SebyR/SmartMed-Dispenser/Poze proiect/20201019_083624.jpg

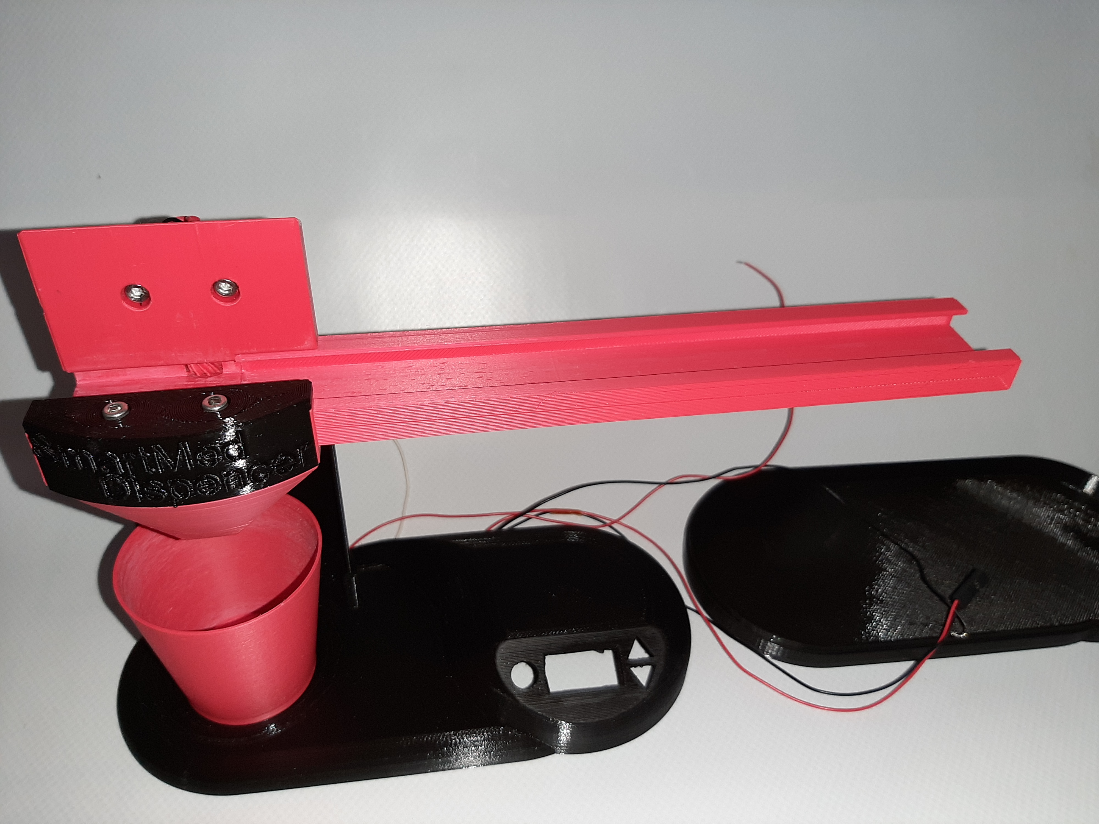
Poze proiect/20201019_083624.jpg
