SebyR/SmartMed-Dispenser/Poze proiect/20201019_083353.jpg

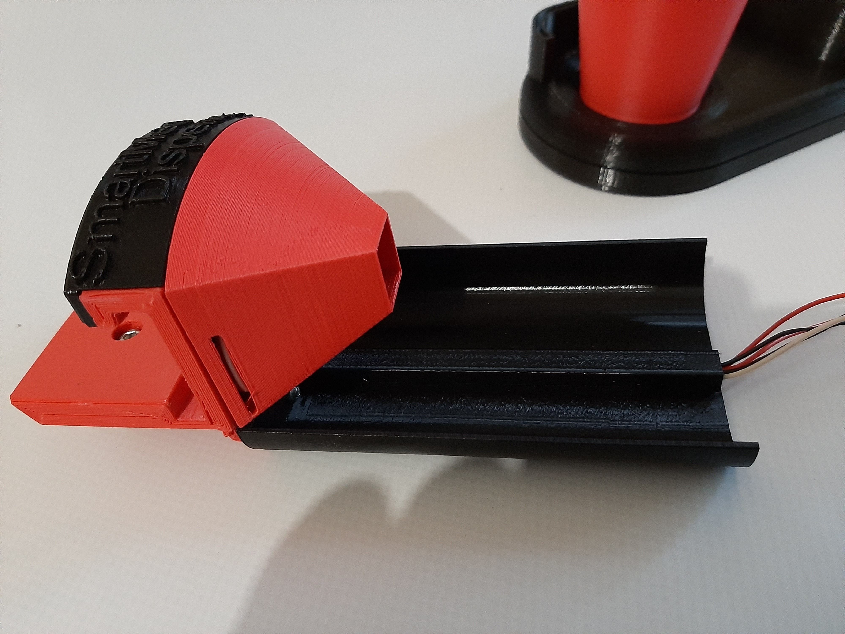
Poze proiect/20201019_083353.jpg
