SebyR/SmartMed-Dispenser/README.md

# SmartMed-Dispenser
Dispozitiv inteligent programabil pentru organizarea și dozarea medicației zilnice a persoanelor în vârstă
