SebyR/SmartMed-Dispenser/Poze proiect/20201018_154645.jpg

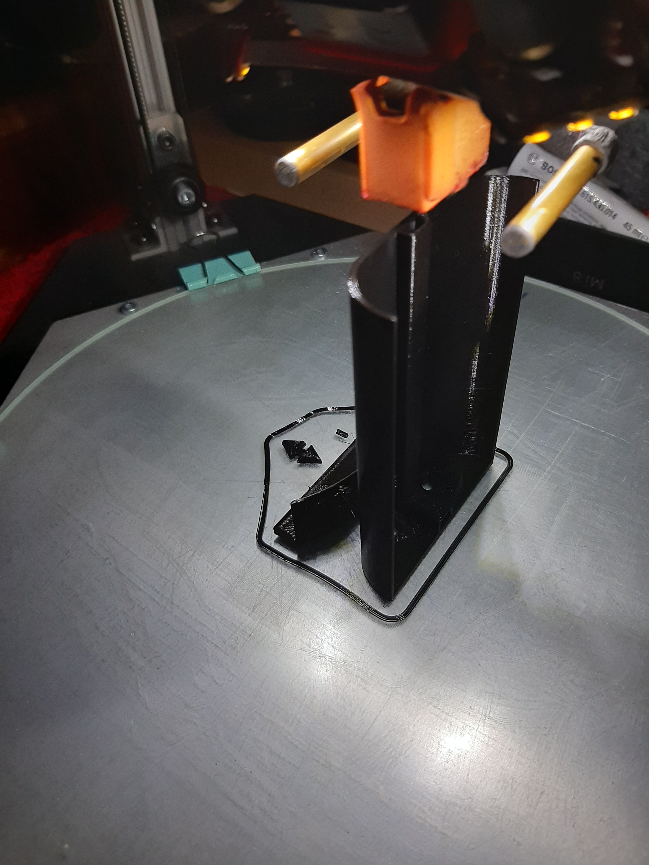
Poze proiect/20201018_154645.jpg
