SebyR/SmartMed-Dispenser/Poze proiect/20201019_083313.jpg

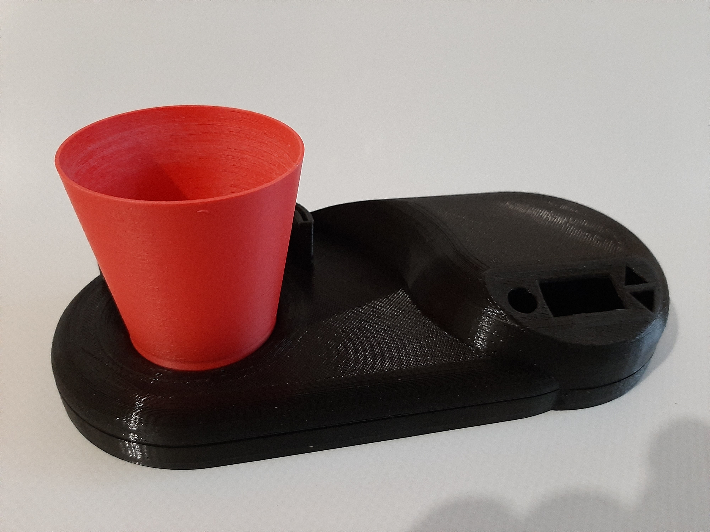
Poze proiect/20201019_083313.jpg
