SebyR/SmartMed-Dispenser/Poze proiect/20201019_083321.jpg

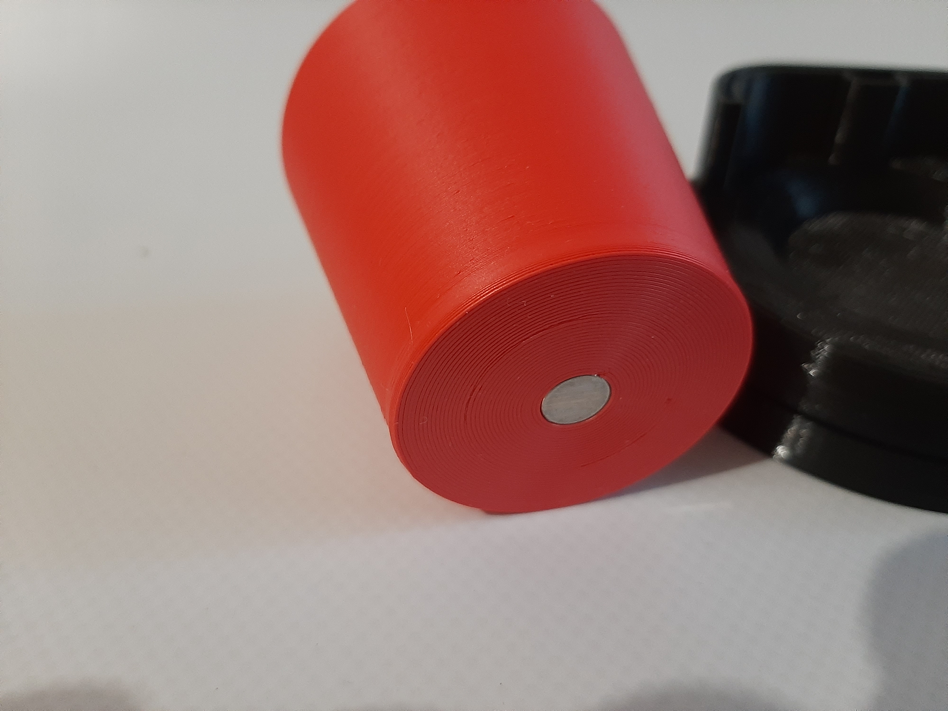
Poze proiect/20201019_083321.jpg
