SebyR/SmartMed-Dispenser/Poze proiect/20201019_083421.jpg

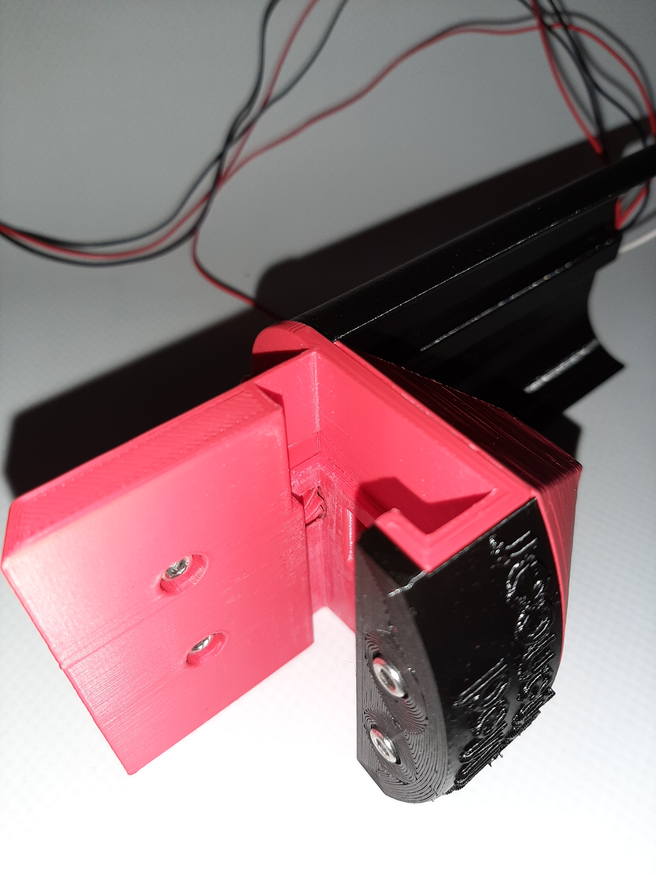
Poze proiect/20201019_083421.jpg
