SebyR/SmartMed-Dispenser/Poze proiect/20201019_083508.jpg

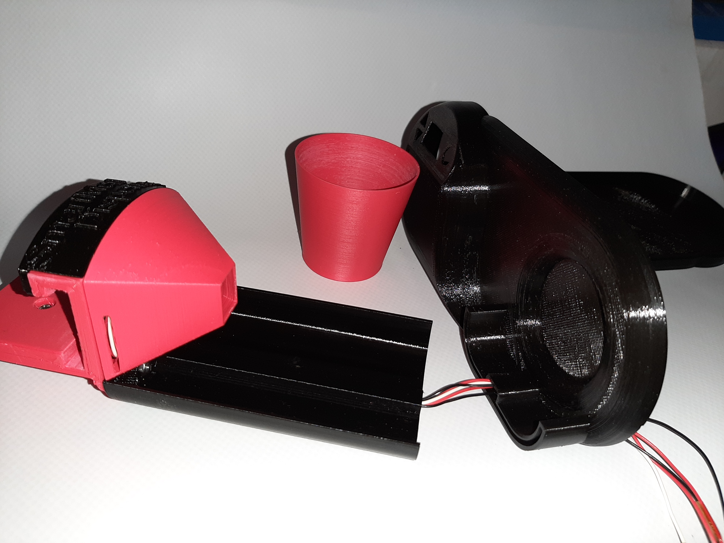
Poze proiect/20201019_083508.jpg
