SebyR/SmartMed-Dispenser/Poze proiect/20201019_083731.jpg

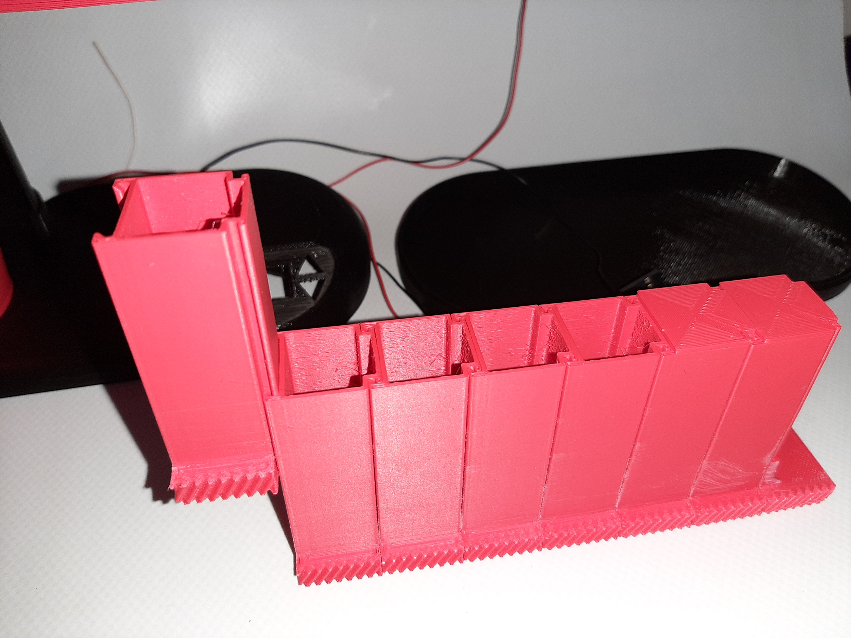
Poze proiect/20201019_083731.jpg
