SebyR/SmartMed-Dispenser/Poze proiect/20201019_083916.jpg

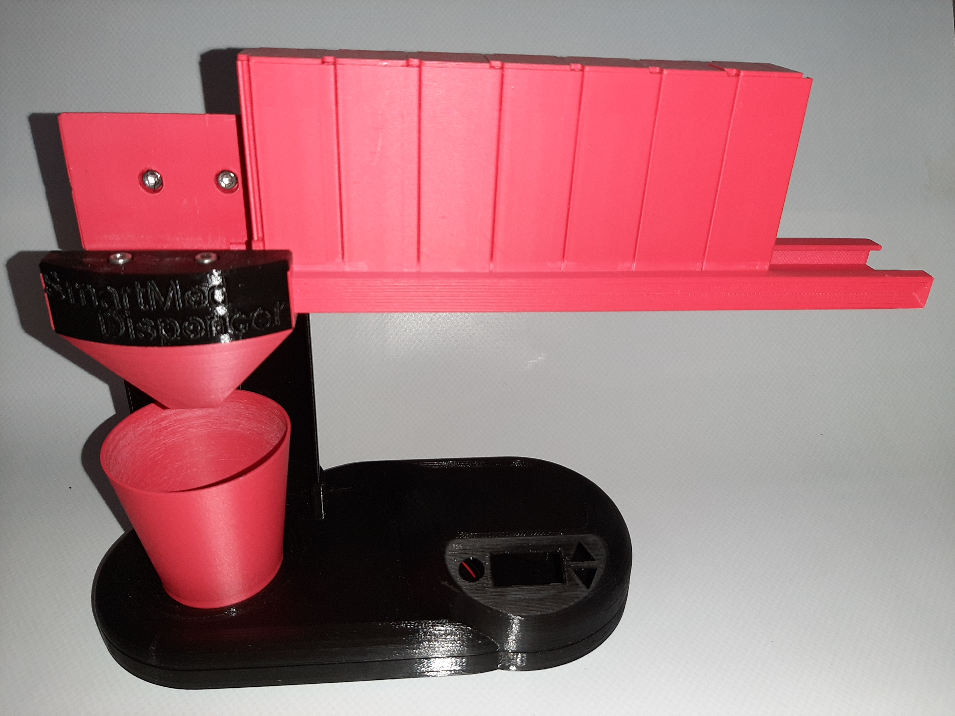
Poze proiect/20201019_083916.jpg
