SebyR/SmartMed-Dispenser/Poze proiect/20210425_174214.jpg

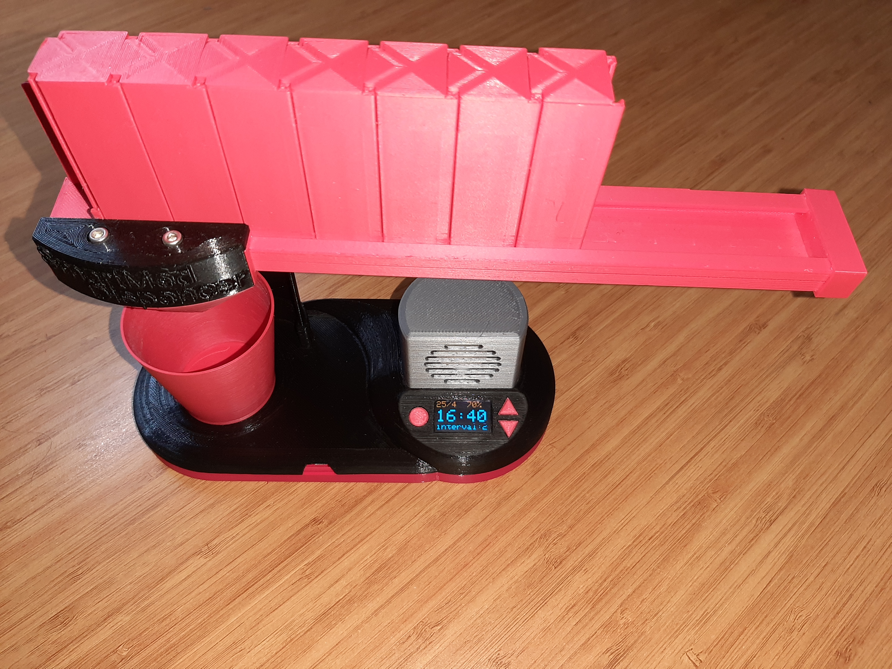
Poze proiect/20210425_174214.jpg
