SebyR/SmartMed-Dispenser/Stl-uri/Sina_dr1.stl

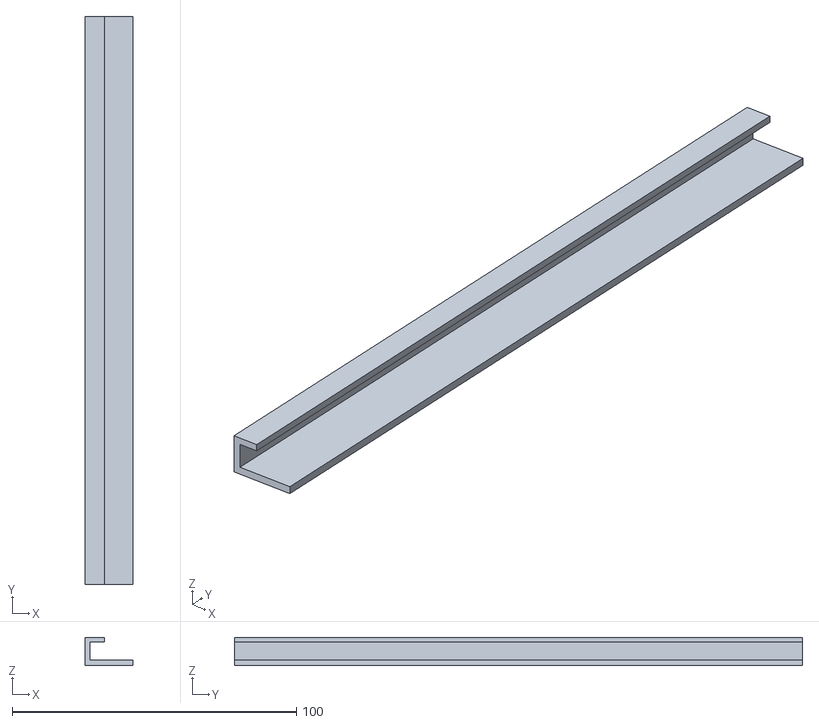
[picture p23: CAD file, 2021-04-27]
Stl-uri/Sina_dr1.stl
17.0 x 200.0 x 10.0
