SebyR/SmartMed-Dispenser/Stl-uri/Pahar.stl

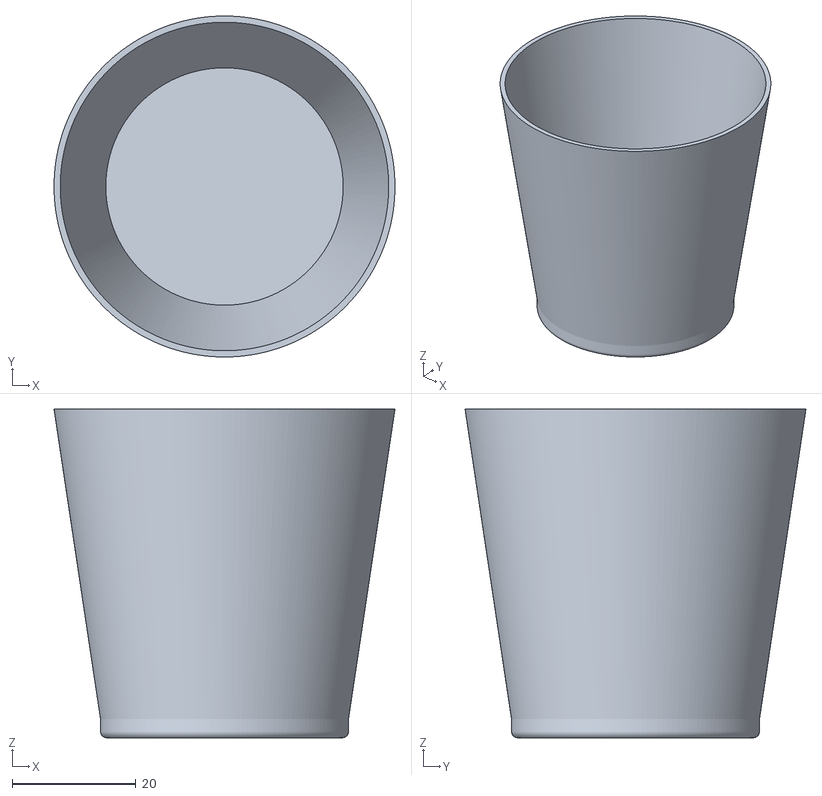
[picture p24: CAD file, 2021-04-27]
Stl-uri/Pahar.stl
55.0 x 55.0 x 53.0
