SebyR/SmartMed-Dispenser/Stl-uri/Capac_frontal.stl

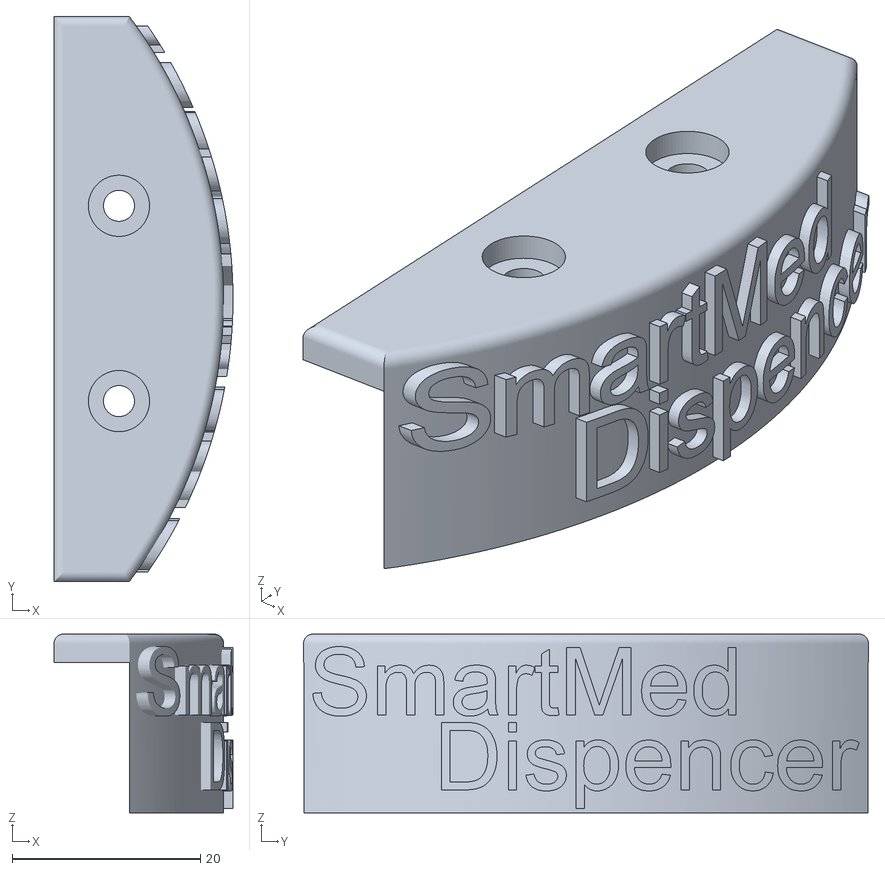
[picture p25: CAD file, 2021-04-27]
Stl-uri/Capac_frontal.stl
19.0 x 60.0 x 19.0
