SebyR/SmartMed-Dispenser/Stl-uri/Capac_sina.stl

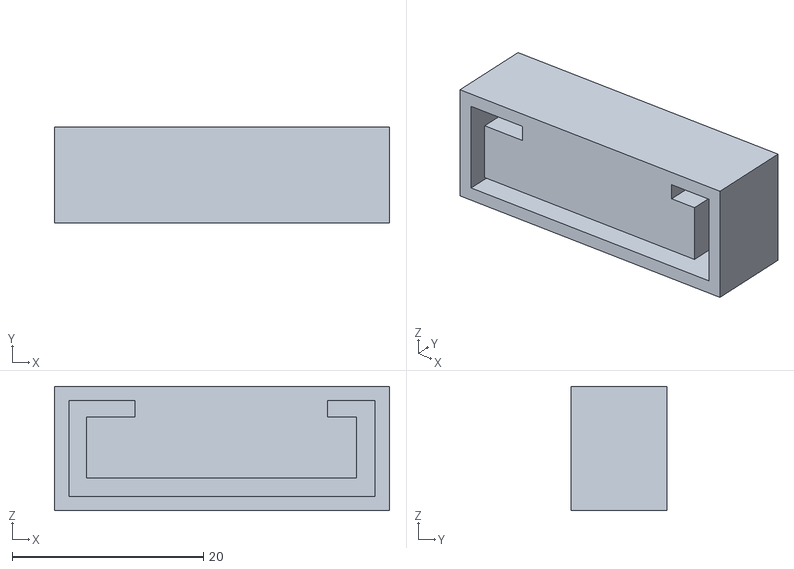
[picture p26: CAD file, 2021-04-27]
Stl-uri/Capac_sina.stl
35.0 x 10.0 x 13.0
