SebyR/SmartMed-Dispenser/Stl-uri/Buton+-.stl

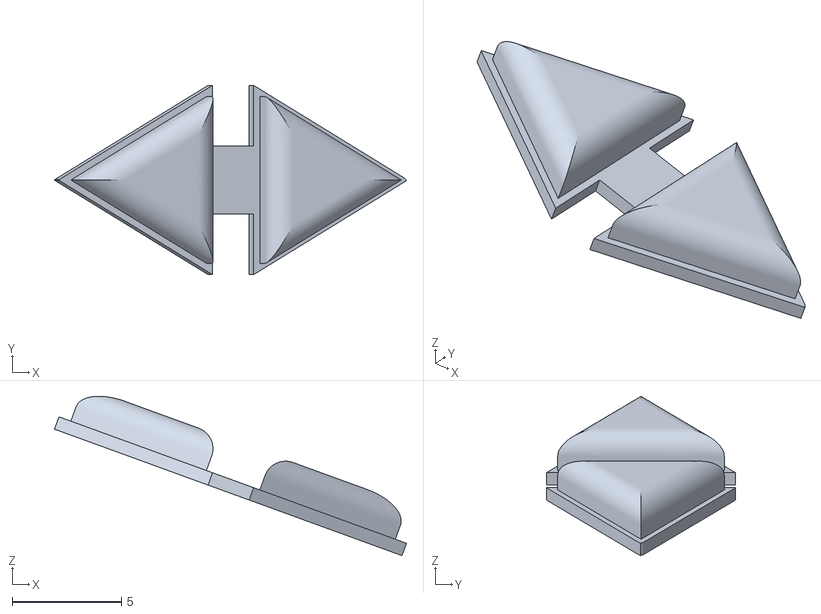
[picture p27: CAD file, 2021-04-27]
Stl-uri/Buton+-.stl
16.1 x 8.66 x 7.29
