SebyR/SmartMed-Dispenser/Stl-uri/Stativ_jos_rosu.stl

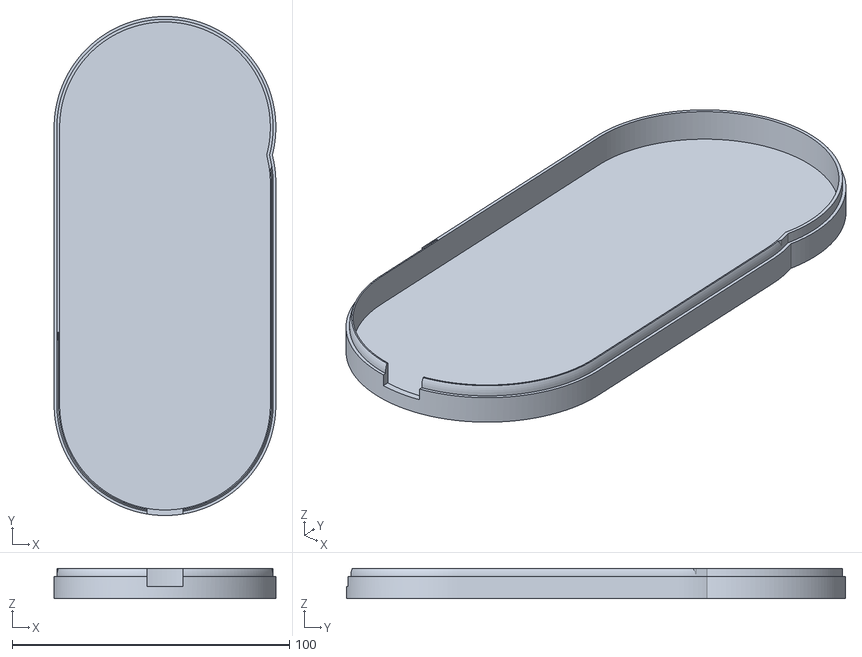
[picture p28: CAD file, 2021-04-27]
Stl-uri/Stativ_jos_rosu.stl
80.0 x 180.0 x 11.0
