SebyR/SmartMed-Dispenser/Stl-uri/Baza_superioara.stl

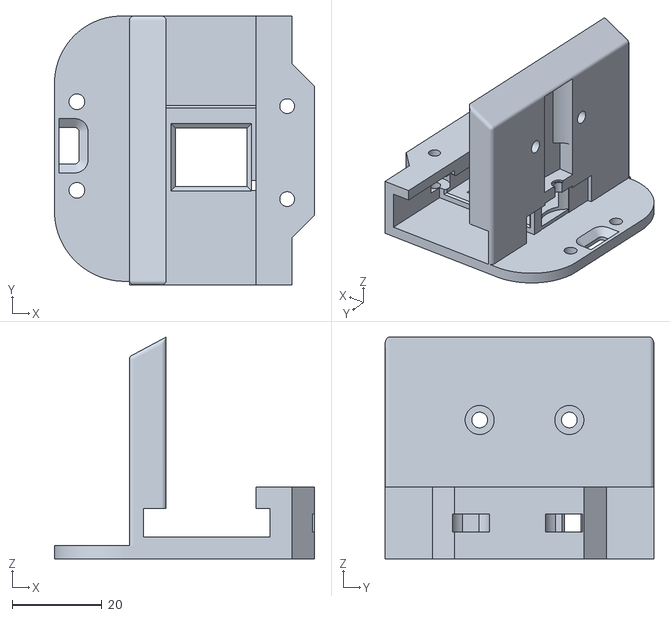
[picture p29: CAD file, 2021-04-27]
Stl-uri/Baza_superioara.stl
58.0 x 60.0 x 49.5
