SebyR/SmartMed-Dispenser/Stl-uri/Stativ.stl

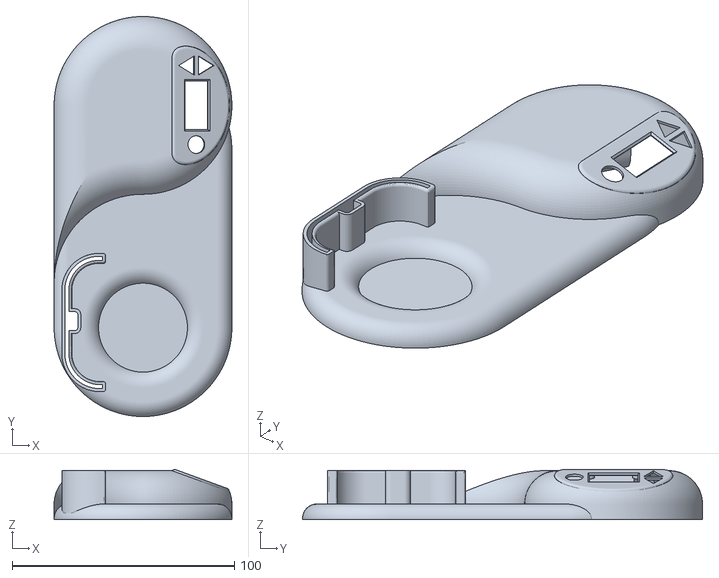
[picture p30: CAD file, 2021-04-27]
Stl-uri/Stativ.stl
80.0 x 180.0 x 22.5
