SebyR/SmartMed-Dispenser/Stl-uri/Buton_Ok.stl

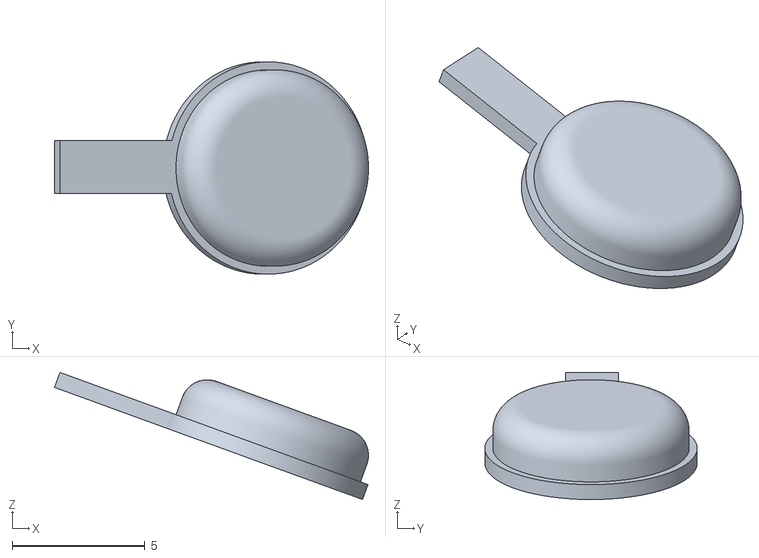
[picture p31: CAD file, 2021-04-27]
Stl-uri/Buton_Ok.stl
11.8 x 8.00 x 4.79
