SebyR/SmartMed-Dispenser/Stl-uri/Baza inferioara.stl

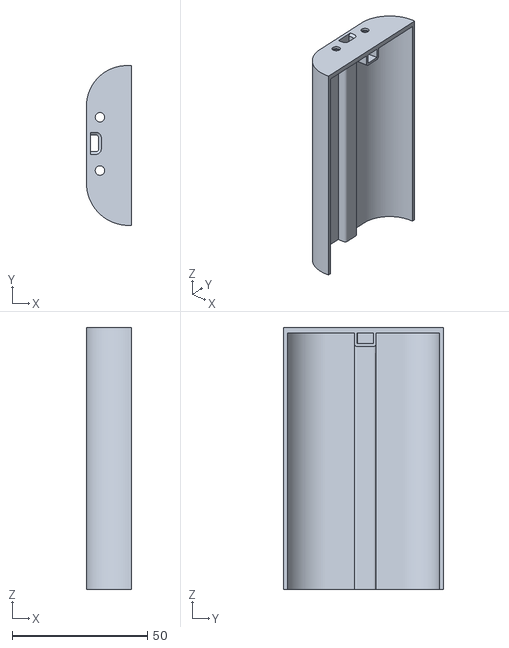
[picture p32: CAD file, 2021-04-27]
Stl-uri/Baza inferioara.stl
16.7 x 59.2 x 97.0
