SebyR/SmartMed-Dispenser/Stl-uri/Capac_doza.stl

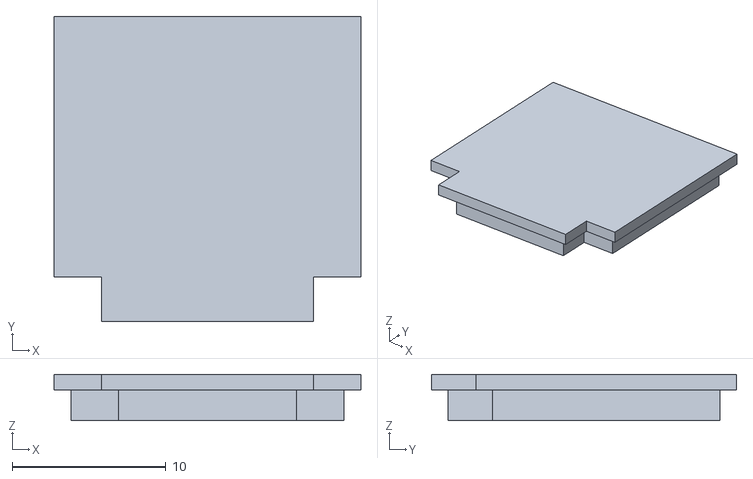
[picture p33: CAD file, 2021-04-27]
Stl-uri/Capac_doza.stl
20.0 x 19.9 x 3.00
