SebyR/SmartMed-Dispenser/Stl-uri/Port_motor.stl

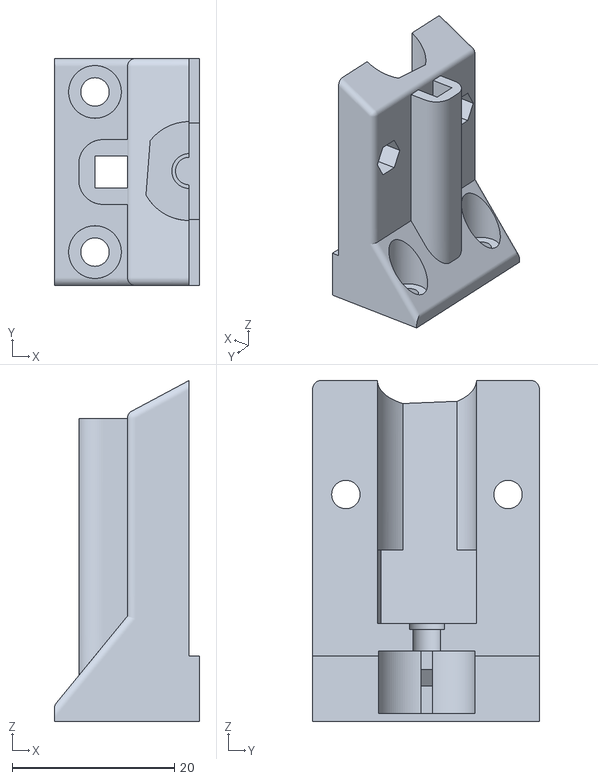
[picture p34: CAD file, 2021-04-27]
Stl-uri/Port_motor.stl
17.9 x 28.0 x 42.1
