SebyR/SmartMed-Dispenser/Stl-uri/pinion.stl

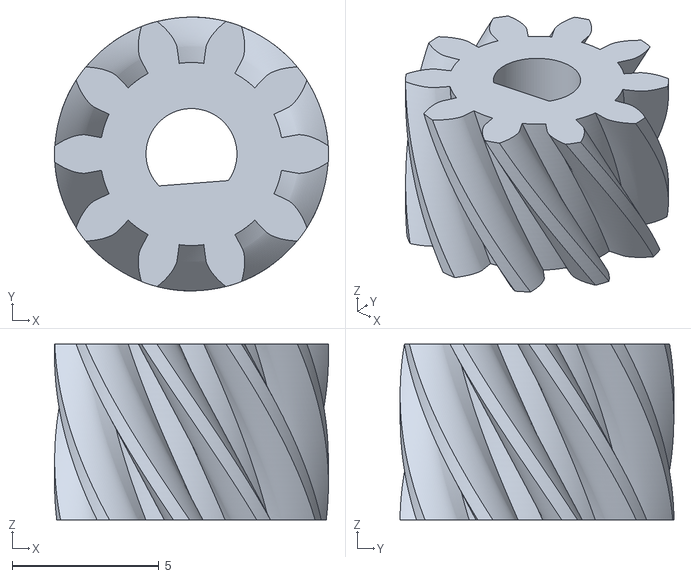
[picture p35: CAD file, 2021-04-27]
Stl-uri/pinion.stl
9.35 x 9.35 x 6.00
