SebyR/SmartMed-Dispenser/Stl-uri/Boxa.stl

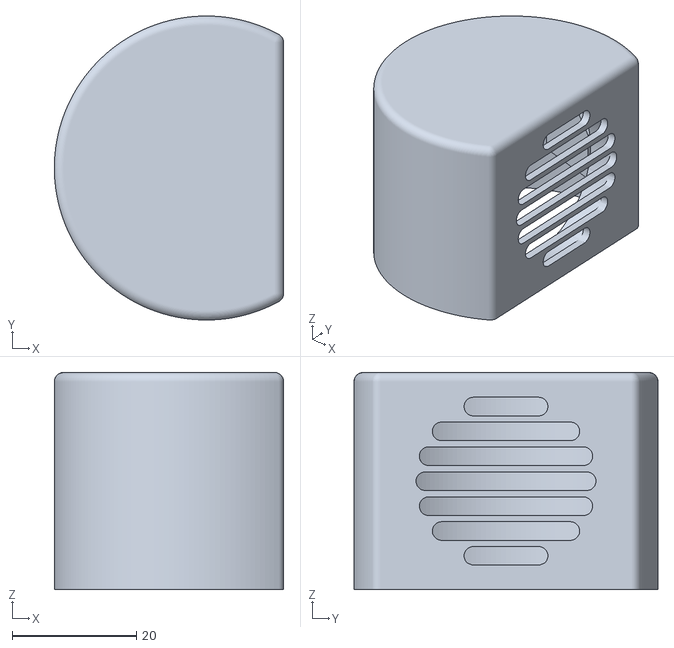
[picture p36: CAD file, 2021-04-27]
Stl-uri/Boxa.stl
37.0 x 49.0 x 35.0
