SebyR/SmartMed-Dispenser/Stl-uri/Sina_st1.stl

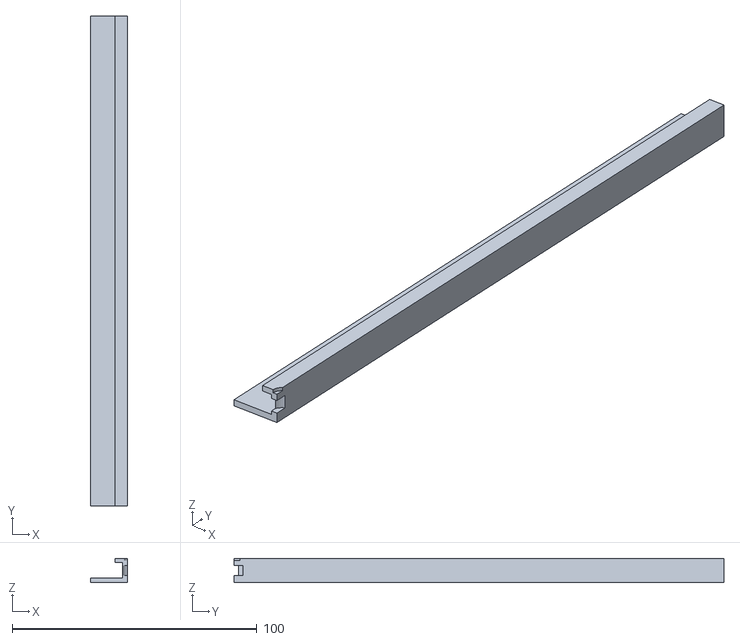
[picture p37: CAD file, 2021-04-27]
Stl-uri/Sina_st1.stl
15.0 x 200.0 x 10.0
