SebyR/SmartMed-Dispenser/Stl-uri/cutie.stl

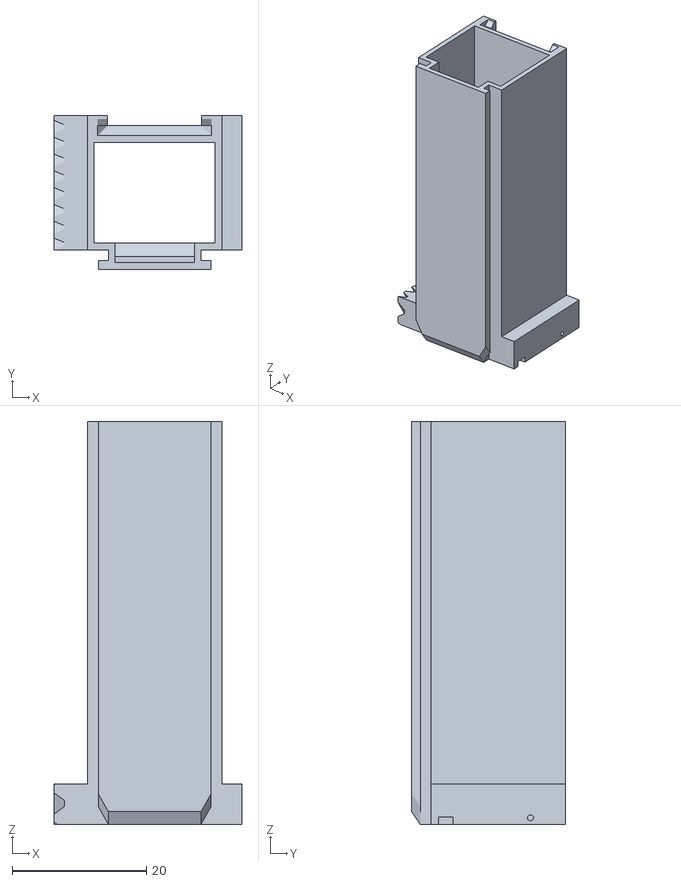
[picture p38: CAD file, 2021-04-27]
Stl-uri/cutie.stl
28.0 x 22.9 x 60.0
