SebyR/SmartMed-Dispenser/Stl-uri/Start.stl

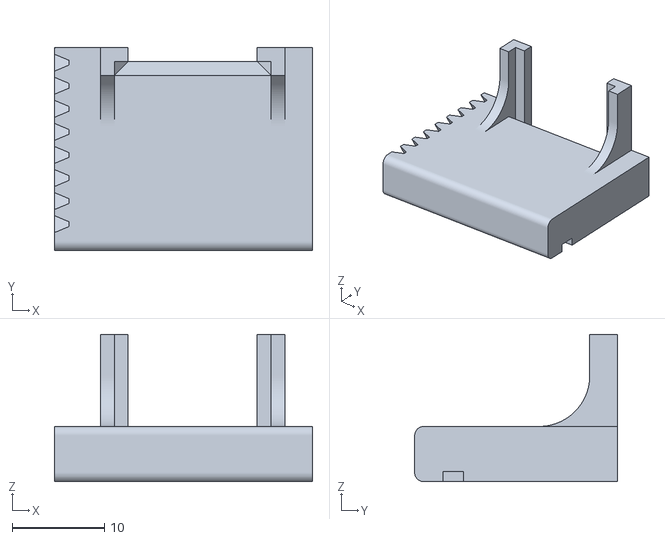
[picture p39: CAD file, 2021-04-27]
Stl-uri/Start.stl
28.0 x 22.0 x 16.0
