SebyR/SmartMed-Dispenser/Stl-uri/Palnie.stl

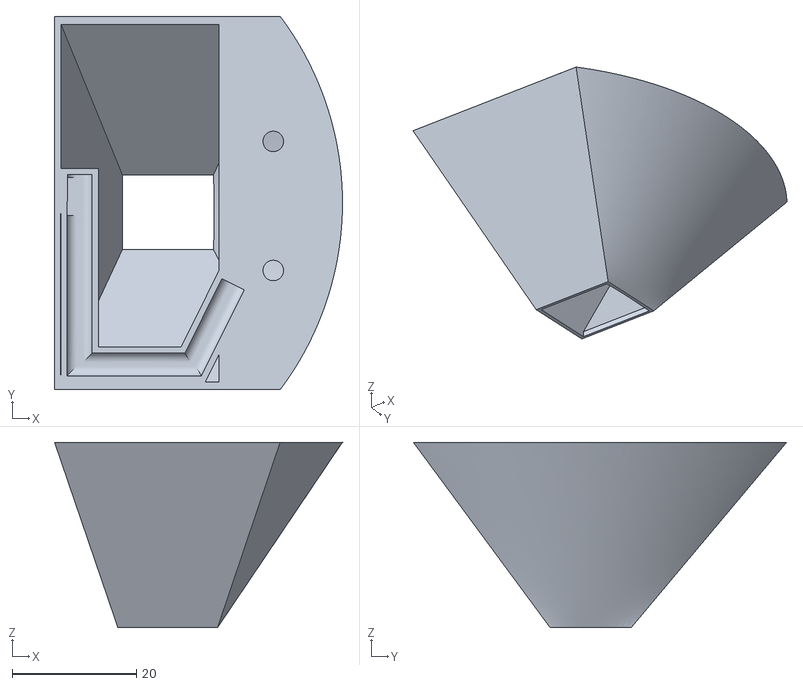
[picture p40: CAD file, 2021-04-27]
Stl-uri/Palnie.stl
46.3 x 60.0 x 29.8
