SebyR/SmartMed-Dispenser/SchemaElectrica.pdf

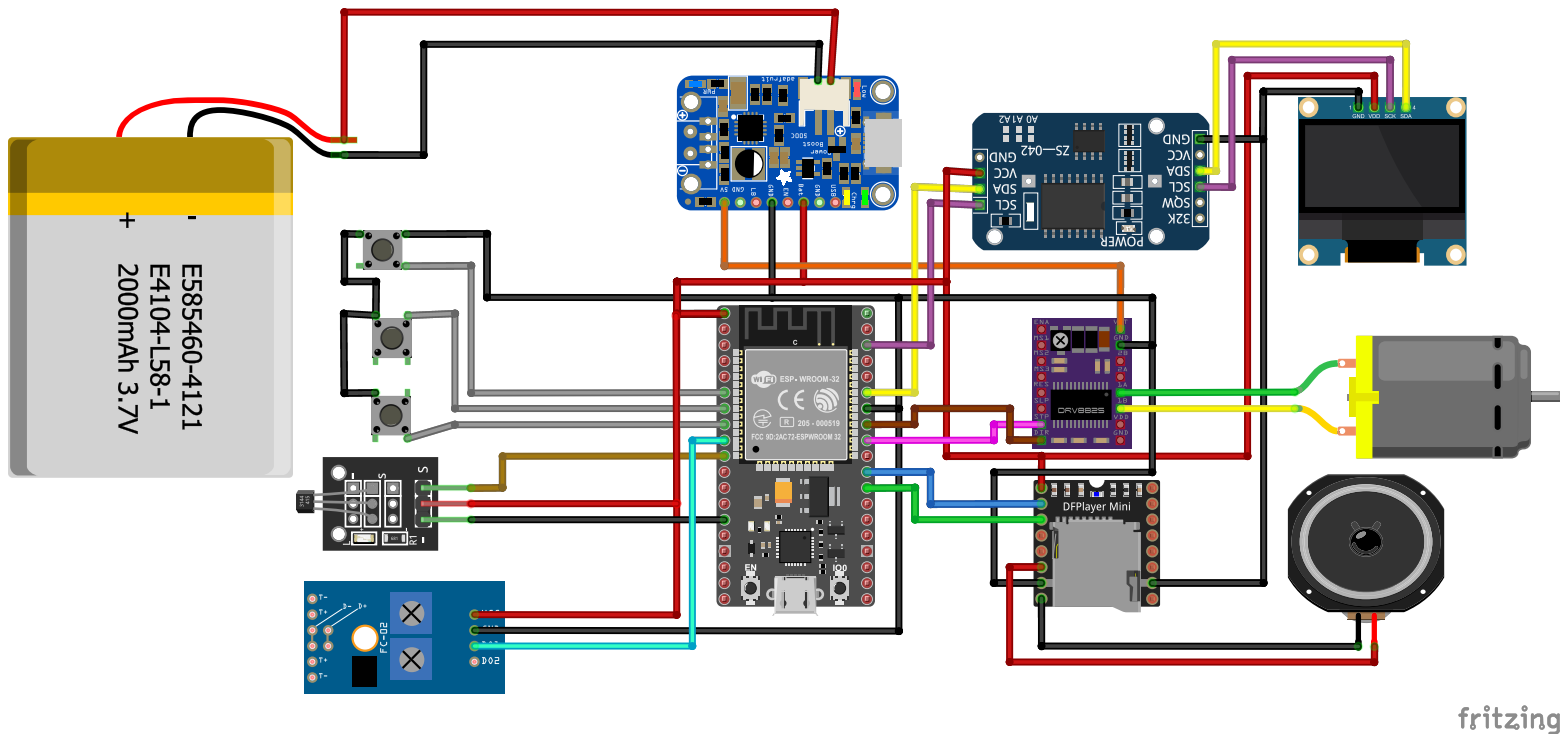
[picture p41: page 1]
